kangouxu/two_bar_resume_base-on-RL/README.md

# two_bar_resume_base-on-RL
a easy and cheap device trained by rl and deployed on esp32
