kangouxu/two_bar_resume_base-on-RL/第2站_行为克隆实战.md

# 第 2 站：从零敲出行为克隆

> 第 1 站结尾你看到：随机策略 reward 为负，机器人起不来。
> 这一站我们**一行一行敲出 `my_pretrain.py`**：用一条"手写的示范轨迹"当教师，监督学习出一个"能大致起身"的初始策略。
>
> 对照实现：`RL/pretrain_robo1_from_scripted.py`、`RL/getup_reference.py`。

---

## 先说一件事：这一站改用完整版环境

第 1 站你敲的 `my_env.py` 是**理解版**（核心观测/动作/奖励）。从这一站开始要真正训练，需要环境的**完整版功能**：

- `reset` 能**指定初始姿态**（`options={"pose": ...}`），而不是只能随机；
- `info` 里能输出 `servo_angles`、`target`、`goal_pose` 等调试信息。

这些仓库的 `robo1_env.py` 都已经有了。**这一站我们直接 `import robo1_env`**（它就是你 `my_env.py` 的完整版，建议打开对比一下多了什么）。

`getup_reference.py`（示范轨迹）也是仓库现成的，不用敲。

---

## Step 0：确认依赖文件都在

在 `RL/` 目录下：

```powershell
python -c "from robo1_env import Robo1GetupEnv; from getup_reference import getup_sequence_for_pose; print('ok')"
```

预期输出：`ok`

再验证一下 `getup_reference.py` 里有多少条示范轨迹：

```powershell
python -c "from getup_reference import getup_sequence_for_pose; print(len(getup_sequence_for_pose('pitch_pos')))"
```

预期输出：`5`（`pitch_pos` 的示范是 5 个 waypoint）。

---

## Step 1：建文件，敲导入

新建 `my_pretrain.py`，敲：

```python
import numpy as np
import torch
import mujoco
from stable_baselines3 import PPO

from getup_reference import getup_sequence_for_pose
from robo1_env import FALLEN_POSES, Robo1GetupEnv, roll_pitch_to_quat
```

逐行说：

- `torch`：做梯度下降（行为克隆的监督学习）。
- `PPO`：我们**只用它的 policy 网络**当"学生"，PPO 训练到第 3 站才用。
- `getup_sequence_for_pose`：拿某姿态的示范 waypoint。
- `FALLEN_POSES`：四种倒地姿态的角度。
- `roll_pitch_to_quat`：摆扰动姿态时用到（和第 1 站你敲的一样）。

---

## Step 2：敲数据增强表

继续往下敲：

```python
POSE_VARIANTS_DEG = {
    "roll_pos": [(0.0, 0.0)],
    "roll_neg": [(0.0, 0.0)],
    "pitch_pos": [(0, 0), (-20, -20), (-20, 0), (-20, 20), (-10, -10), (-10, 10),
                  (0, -20), (0, 20), (10, -10), (10, 10), (20, -20), (20, 0), (20, 20)],
    "pitch_neg": [(0.0, 0.0)],
}
```

说明：

- 每个元素是 `(roll偏移°, pitch偏移°)`，表示"把机器人摆到倒地姿态后，再额外偏一点角度"。
- **只对 `pitch_pos` 做了 13 个变体**，其他只有 1 个——因为作者发现**前后倒（pitch）方向更难、对初始角度更敏感**。
- 作用：让策略别只记住"某一个精确角度"，而是学会"这个姿态附近都能起"。这是数据增强/泛化技巧。

---

## Step 3：敲 waypoint → 连续目标角

继续往下敲：

```python
def expert_target_schedule(env, sequence):
    targets = []
    prev = np.zeros(2, dtype=np.float64)
    for waypoint in sequence:
        for i in range(350):
            t = (i + 1) / 350
            ctrl = (1.0 - t) * prev + t * waypoint
            if i % env.frame_skip == env.frame_skip - 1:
                targets.append(ctrl.copy())
        prev = waypoint
    for _ in range(150):
        targets.append(np.zeros(2, dtype=np.float64))
    return targets
```

说明（逐块）：

- waypoint 只是几个"关键帧"，机器人不能瞬间跳过去，所以**线性插值**成平滑轨迹。
- 每个 waypoint 用 350 步插值；`i % frame_skip == frame_skip - 1` 是**每 20 步采样一次**——保证这条轨迹和 env 的动作频率一致。
- 末尾 150 步回零：起完身让舵机回正。

---

## Step 4：敲"误差 → 动作"的翻译

继续往下敲：

```python
def scripted_action(env, waypoint):
    error = waypoint - env.target
    return np.clip(error / env.target_delta, -1.0, 1.0).astype(np.float32)
```

**这是全文件最关键的一行。** 回忆第 1 站 env 的动作规则：`target += action * target_delta`。反推：要走到 `waypoint`，动作应该是 `(waypoint - target) / target_delta`。

这一行把示范的"**要去哪**"翻译成策略该输出的"**这一步动多少**"——示范轨迹和 RL 动作之间，就靠它搭桥。

---

## Step 5：敲 reset_variant（摆扰动初始姿态）

继续往下敲：

```python
def reset_variant(env, pose, roll_offset_deg, pitch_offset_deg):
    base_roll, base_pitch = FALLEN_POSES[pose]
    roll = base_roll + np.deg2rad(roll_offset_deg)
    pitch = base_pitch + np.deg2rad(pitch_offset_deg)

    env.data.qpos[:] = 0.0
    env.data.qvel[:] = 0.0
    env.data.qpos[0:3] = [0.0, 0.0, 0.08]
    env.data.qpos[3:7] = roll_pitch_to_quat(roll, pitch)
    env.target[:] = 0.0
    env.data.ctrl[:] = 0.0
    mujoco.mj_forward(env.model, env.data)

    for _ in range(env.settle_steps):
        env.data.ctrl[:] = 0.0
        mujoco.mj_step(env.model, env.data)

    env.target[:] = 0.0
    env.data.ctrl[:] = 0.0
    env.step_count = 0
    env.success_count = 0
    env.prev_upright = env._upright()
    env.current_pose_name = pose
    return env._get_obs(), {"pose": pose}
```

说明：

- 前几行：把倒地姿态的 `(roll, pitch)` 加上扰动偏移，转成四元数摆上去——和第 1 站 `_set_pose` 几乎一样，只是多了扰动。
- `settle_steps` 循环：让身体落地稳定再开始。
- 末尾重置 `target / step_count / prev_upright`，返回初始观测。

---

## Step 6：敲 collect_expert_data（滚数据）

继续往下敲：

```python
def collect_expert_data():
    observations = []
    actions = []
    for pose in ("roll_pos", "roll_neg", "pitch_pos", "pitch_neg"):
        for roll_off, pitch_off in POSE_VARIANTS_DEG[pose]:
            env = Robo1GetupEnv("robo1.xml", fallen_poses=(pose,))
            obs, _ = reset_variant(env, pose, roll_off, pitch_off)
            for waypoint in expert_target_schedule(env, getup_sequence_for_pose(pose)):
                action = scripted_action(env, waypoint)
                observations.append(obs.copy())
                actions.append(action.copy())
                obs, _, terminated, truncated, _ = env.step(action)
                if terminated or truncated:
                    break
    return (np.asarray(observations, dtype=np.float32),
            np.asarray(actions, dtype=np.float32))
```

说明：

- 双重循环：遍历 4 种姿态 × 各自的变体。
- 内层：把示范轨迹在 env 里**真实 roll-out**，每走一步记一对 `(观测, 动作)`——这就是监督学习的 `(输入, 标签)`。
- 注意记的是**这一步之前的 `obs`** 和**这一步要做的 `action`**，配对要正确。

**运行验证**（确认数据收集正常）：

```powershell
python -c "import my_pretrain; o, a = my_pretrain.collect_expert_data(); print(o.shape, a.shape)"
```

预期输出：`(N, 4) (N, 2)`，N 约 3600（具体略少，因为有些变体会提前 break）。

---

## Step 7：敲 main（行为克隆训练）

继续往下敲：

```python
def main():
    observations, actions = collect_expert_data()
    env = Robo1GetupEnv("robo1.xml")
    model = PPO("MlpPolicy", env, n_steps=512, batch_size=256,
                learning_rate=3e-4, gamma=0.99, verbose=0, device="cpu")

    obs_tensor = torch.as_tensor(observations, dtype=torch.float32, device=model.device)
    act_tensor = torch.as_tensor(actions, dtype=torch.float32, device=model.device)
    optimizer = torch.optim.Adam(model.policy.parameters(), lr=1e-3)

    for epoch in range(5000):
        dist = model.policy.get_distribution(obs_tensor)
        loss = torch.mean((dist.distribution.mean - act_tensor) ** 2)
        optimizer.zero_grad()
        loss.backward()
        optimizer.step()
        if epoch % 500 == 0:
            print(f"epoch {epoch}, loss {float(loss):.6f}")

    print("expert_samples:", len(observations))
    model.save("robo1_getup_ppo")

if __name__ == "__main__":
    main()
```

说明（关键几行）：

- `model = PPO(...)`：先建一个 PPO 对象，但**只用它的 `policy`（actor）网络**当学生。
- `dist.distribution.mean`：policy 网络输出的**预测动作**。
- `loss = mean((pred - act)^2)`：**MSE 监督损失**——让预测动作逼近示范动作。这就是行为克隆。
- 不调 `model.learn()`，而是手写 `optimizer` 循环——因为这是监督学习，不是强化学习。
- 训练完 `model.save` 存成 `robo1_getup_ppo`（这是第 3 站 PPO 精调的起点）。

**运行验证**：

```powershell
python my_pretrain.py
```

预期：`loss` 从某个值一路下降到很小（如从 0.1 降到 0.001 以下）；最后打印 `expert_samples: ~3600`。训练很快（数据量小）。

> 注意：`model.save` 会**覆盖**同名文件。如果目录里已有 `robo1_getup_ppo.zip`（仓库自带的训练好模型），建议先备份，或把这一站的输出改个名（如 `my_ppo`），免得覆盖掉现成模型。

---

## Step 8：验证——克隆出来的策略能起身吗

新建 `my_eval.py`，敲：

```python
from stable_baselines3 import PPO
from robo1_env import Robo1GetupEnv

model = PPO.load("robo1_getup_ppo")
for pose in ("roll_pos", "roll_neg", "pitch_pos", "pitch_neg"):
    env = Robo1GetupEnv("robo1.xml", fallen_poses=(pose,))
    obs, _ = env.reset(options={"pose": pose})
    best = -1.0
    for _ in range(env.max_steps):
        action, _ = model.predict(obs, deterministic=True)
        obs, _, terminated, truncated, info = env.step(action)
        best = max(best, info["upright"])
        if terminated or truncated:
            break
    print(pose, "best_upright:", round(best, 4))
```

```powershell
python my_eval.py
```

预期：四种姿态的 `best_upright` 都能到 **0.9 以上**（`upright > 0.95` 才算严格 `goal_pose`）。

如果某个姿态起不来，通常是那条示范 waypoint 不够好。这时可以用仓库的 `search_all_getup.py` **自动搜索更好的轨迹**：

```powershell
python search_all_getup.py --pose pitch_pos
```

它会暴力枚举 + 随机采样一批候选 waypoint，逐个试、打分，把最好的打印出来，你再回填到 `getup_reference.py`。

---

## 下一步

现在你有了一个"能大致起身"的初始策略，但它只会死记硬背示范，不够鲁棒。

下一站（**第 3 站**）用 PPO 在仿真里继续精调，把它打磨成"真会应对各种情况"的策略。
