kangouxu/two_bar_resume_base-on-RL/第4站_导出与实机部署.md

# 第 4 站：从零敲出导出脚本 + 实机部署

> 第 3 站你在仿真里练出了鲁棒策略。这一站把它从 Python 搬到 **M5Atom（ESP32 单片机）**。
> 前半部分**逐行敲出 `my_export.py`**（把策略变 C 头），后半部分**逐段读懂**现成固件 `robo03.ino`，最后照着清单部署。
>
> 对照实现：`RL/export_policy_header.py`、`Arduino/robo03/robo03.ino`。

---

## 先明确：策略网络到底长什么样

SB3 的 `MlpPolicy` 就是一个 4 进 2 出的小 MLP：

```
4 → 64 (tanh) → 64 (tanh) → 2 (线性)
```

- 前两层是 `policy_net`（隐藏层，用 **tanh** 激活）。
- 最后一层是 `action_net`（输出层，**无激活**，直接线性）。

导出就是把这三层的**权重和偏置**写成 C 数组，再手写一个"矩阵乘法 + tanh"的前向函数。ESP32 没有 Python，只能这样把网络"搬过去"。

---

## Step 0：确认有训练好的模型

```powershell
python -c "from stable_baselines3 import PPO; PPO.load('robo1_getup_ppo'); print('ok')"
```

预期输出：`ok`（用第 3 站训练好的模型，或仓库自带的）。

---

## Step 1：敲 my_export.py —— 提取权重

新建 `my_export.py`，敲：

```python
import re
from stable_baselines3 import PPO

def extract_layers(model):
    sd = model.policy.state_dict()
    weights, biases = {}, {}

    def order(key):
        if "policy_net" in key:
            m = re.search(r"policy_net\.(\d+)", key)
            return int(m.group(1)) if m else 0
        return 10 ** 6      # action_net 排最后

    for key, val in sd.items():
        if not ("policy_net" in key or "action_net" in key):
            continue
        if key.endswith(".weight"):
            weights[order(key)] = val.detach().cpu().numpy()
        elif key.endswith(".bias"):
            biases[order(key)] = val.detach().cpu().numpy()

    return [{"W": weights[i], "b": biases[i]} for i in sorted(weights)]
```

说明：

- `model.policy.state_dict()`：一个字典，key 是层名，value 是 PyTorch 张量。
- `order`：SB3 的 `policy_net` 是 `Sequential`，层名是 `policy_net.0`、`policy_net.2`……（Linear 和 Tanh 交替，Linear 在偶数位），所以用正则抓数字排序；`action_net` 用一个很大的数排到最后。
- 只收 `.weight` 和 `.bias`（Linear 层），忽略 Tanh（激活没有参数）。
- `val.detach().cpu().numpy()`：从 GPU 图里摘出来，转成 NumPy 数组。

---

## Step 2：敲 my_export.py —— 写 C 数组

继续往下敲：

```python
def write_c_array(name, arr):
    if arr.ndim == 2:
        rows, cols = arr.shape
        lines = [f"static const float {name}[{rows}][{cols}] = {{"]
        for row in arr:
            lines.append("    {" + ", ".join(f"{x:.8f}" for x in row) + "},")
        lines.append("};\n")
        return "\n".join(lines)
    else:
        return (f"static const float {name}[{arr.shape[0]}] = {{\n"
                + ", ".join(f"{x:.8f}" for x in arr) + "\n};\n")
```

说明：二维数组输出成 `static const float 名字[行][列] = { {...}, {...} };`，一维同理。`.8f` 保留 8 位小数，精度足够推理用。

---

## Step 3：敲 my_export.py —— 生成前向函数

继续往下敲：

```python
def generate_forward(layers):
    code = ["#include <math.h>",
            "static inline void forward_policy(const float input[], float output[]) {",
            "    const float *curr = input;"]
    for i, layer in enumerate(layers):
        W, b = layer["W"], layer["b"]
        out_dim, in_dim = W.shape
        code.append(f"    static float layer{i}[{out_dim}];")
        code.append(f"    for (int i = 0; i < {out_dim}; i++) {{")
        code.append(f"        float s = w{i}_bias[i];")
        code.append(f"        for (int j = 0; j < {in_dim}; j++)")
        code.append(f"            s += w{i}_weight[i][j] * curr[j];")
        if i < len(layers) - 1:
            code.append(f"        layer{i}[i] = tanhf(s);")   # 隐藏层 tanh
        else:
            code.append(f"        layer{i}[i] = s;")          # 输出层线性
        code.append("    }")
        code.append(f"    curr = layer{i};")
    final = layers[-1]["W"].shape[0]
    code.append(f"    for (int i = 0; i < {final}; i++) output[i] = curr[i];")
    code.append("}")
    return "\n".join(code)
```

说明（这是**全文件最关键的一段**）：

- 逐层生成 C 代码：每层先 `s = bias + Σ(weight × 输入)`，再写回 `layer`。
- **隐藏层用 `tanhf(s)`，输出层直接 `s`（线性）**——这必须和 PyTorch 里 MlpPolicy 的定义**完全一致**，否则实机推理结果对不上。
- 每层输出 `curr = layer{i}`，喂给下一层。这就是"矩阵乘法 + tanh"的前向传播，没有框架。

---

## Step 4：敲 my_export.py —— main

继续往下敲：

```python
def main():
    model = PPO.load("robo1_getup_ppo")
    layers = extract_layers(model)

    with open("policy_network.h", "w") as f:
        f.write("// Auto-generated policy-only MLP\n\n#pragma once\n\n")
        f.write(f"#define OBS_DIM {layers[0]['W'].shape[1]}\n")
        f.write(f"#define ACTION_DIM {layers[-1]['W'].shape[0]}\n\n")
        for i, layer in enumerate(layers):
            f.write(write_c_array(f"w{i}_weight", layer["W"]))
            f.write(write_c_array(f"w{i}_bias", layer["b"]))
        f.write(generate_forward(layers))
    print("Generated policy_network.h")

if __name__ == "__main__":
    main()
```

说明：

- `OBS_DIM` = 第一层权重的列数（=4），`ACTION_DIM` = 最后一层的行数（=2）。
- 依次写出每层的权重、偏置，最后写前向函数。

**运行验证**：

```powershell
python my_export.py
```

预期输出：`Generated policy_network.h`。打开看，开头应该是 `#define OBS_DIM 4`、`#define ACTION_DIM 2`，以及一堆 `static const float` 数组。

> 把生成的 `policy_network.h` 放进 `Arduino/robo03/` 目录，`robo03.ino` 会 `#include "policy_network.h"` 引用它。

---

## Step 5：逐段读懂 `robo03.ino`（固件是现成的，读+改）

下面不是敲，是**读懂**现成固件怎么和仿真对齐。打开 `Arduino/robo03/robo03.ino`，分四块读。

### 5.1 姿态估计：IMU + 卡尔曼滤波（对应仿真的 roll/pitch）

```cpp
// robo03.ino:185-189  加速度计算粗略角度
theta_X = atan2(accY, sqrt(accX*accX + accZ*accZ)) * RAD_TO_DEG;

// robo03.ino:513-520  卡尔曼融合陀螺仪 + 加速度计
kalAngleX = kalmanX.getAngle(theta_X, gyroX, dt);
pitch = kalAngleX * DEG_TO_RAD;
roll  = -kalAngleY * DEG_TO_RAD;
```

为什么卡尔曼：加速度计噪声大但有绝对参考，陀螺仪短时准但会漂移，卡尔曼融合两者得稳定角度。**这正好对应仿真里从四元数算出的 roll/pitch**。

### 5.2 控制循环（对应 env 的 step）

```cpp
// robo03.ino:146-163
float obs[OBS_DIM] = {roll, pitch, servo1_target, servo2_target};  // 组观测
float action[ACTION_DIM];
forward_policy(obs, action);                                        // 前向推理

servo1_target += action[0] * TARGET_DELTA_RAD;                      // 增量，和仿真一样
servo1_target = clampf(servo1_target, -TARGET_LIMIT_RAD, TARGET_LIMIT_RAD);
```

对照第 1 站 env 的 `step`：观测、动作增量、限幅，**逐行对应**。控制周期是 20ms（`GETUP_PERIOD_US=20000`，`robo03.ino:51`），正好 = 仿真 `frame_skip=20 × 0.001s`。

### 5.3 状态机 + 自动起身

`robo03.ino:39-44` 定义了几种模式：`MANUAL`（手动）/ `GETUP`（起身中）/ `GETUP_DONE`（成功）/ `GETUP_ABORT`（超时）。

两个实用机制：

- **成功判定**：roll、pitch 都小于阈值并保持 700ms → 判"站直"，停止策略（`robo03.ino:166-174`）。
- **自动起身**：检测倒地（倾角 > 0.75rad 持续 300ms）→ 自动触发起身（`robo03.ino:112-137`）。所以机器人倒了能自己爬起来。

### 5.4 舵机 PWM 映射

```cpp
// robo03.ino:71-79
int deg1 = (int)roundf(target1 * RAD_TO_DEG);
deg1 = (int)clampf(deg1, -90, 90);
servo1.write(-deg1 + 90);     // -90°..90° 映射到 0°..180°
```

策略输出弧度，舵机要 PWM 角度，这里做转换。换舵机时，`offset`/`pulse` 在 Web 界面调（`robo03.ino:294-396`），存 Preferences 持久化。

---

## Step 6：部署步骤清单

1. **装依赖**：Arduino IDE 装 `M5Atom`、`Kalman`、`ESP32Servo` 库，选 ESP32 板卡。
2. **导出策略**：`python my_export.py`，把 `policy_network.h` 放进 `Arduino/robo03/`。
3. **接线**：servo1 → GPIO 26，servo2 → GPIO 32。
4. **烧录**：Arduino IDE 打开 `robo03.ino`，编译上传到 M5Atom。
5. **上电**：M5Atom 建热点 `robo1`（密码 `password`），连上后浏览器访问 `http://192.168.42.1`。
6. **校准**：网页上把两个舵机的 `offset`（中心）和 `pulse`（行程）调到 ±90° 对应实际关节行程。
7. **起身**：网页点 `GETUP`，或按 M5Atom 本体按钮。

---

## sim-to-real gap 从哪来

代码全对，实机也不一定第一次就起。差距通常来自：

- **舵机扭矩不够**：MuJoCo 里执行器是理想化的（`kp=0.5`，没建模扭矩上限），换更弱的舵机可能甩不动。
- **装配/重心偏差**：3D 打印件重心和仿真 STL 不完全一致。
- **IMU 噪声**：卡尔曼参数没调好，姿态抖动。

这些不是 bug，是物理现实——所以这个项目把舵机偏移做成网页可调：**每个实机都不同，必须现场调**。

---

## 全流程回顾

四站走完，你走通了完整链路：

```
第1站 env ──► 第2站 行为克隆 ──► 第3站 PPO ──► 第4站 导出+实机
(观测/动作/奖励)  (示范轨迹)      (精调)        (C头 + M5Atom)
```

贯穿始终的那根线，就是**观测、动作、频率三条对齐**——它让仿真里每个设计决策，最终都在实体机器人的 20ms 循环里一一兑现。
