kangouxu/two_bar_resume_base-on-RL/armhornP.stl

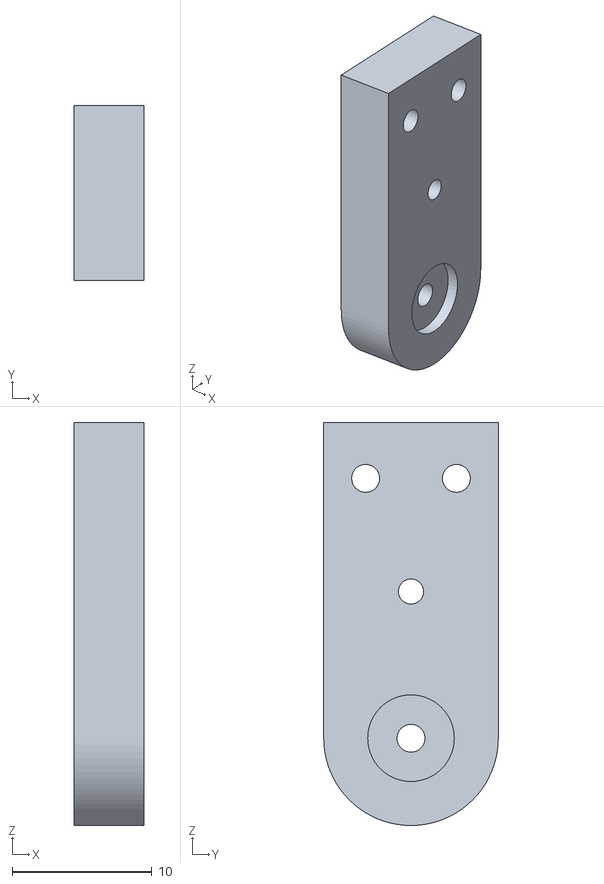
[picture p1: CAD file, 2026-10-21]
armhornP.stl
5.00 x 12.5 x 28.9
