kangouxu/two_bar_resume_base-on-RL/assets/servo1.stl

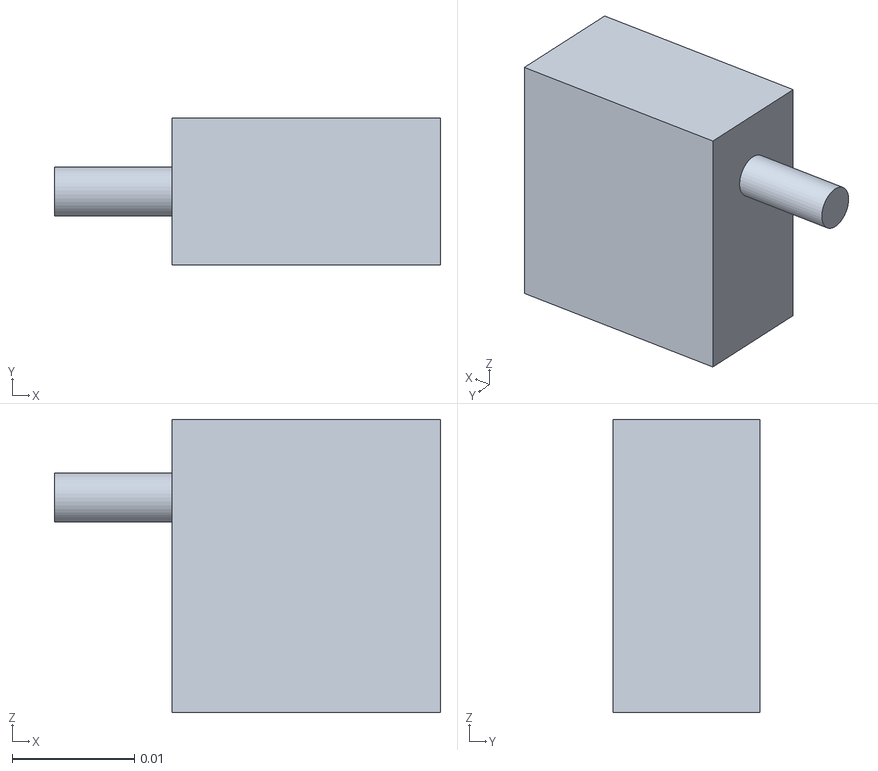
[picture p2: CAD file, 2026-10-16]
assets/servo1.stl
0.0316 x 0.012 x 0.024
