kangouxu/two_bar_resume_base-on-RL/arm2P.stl

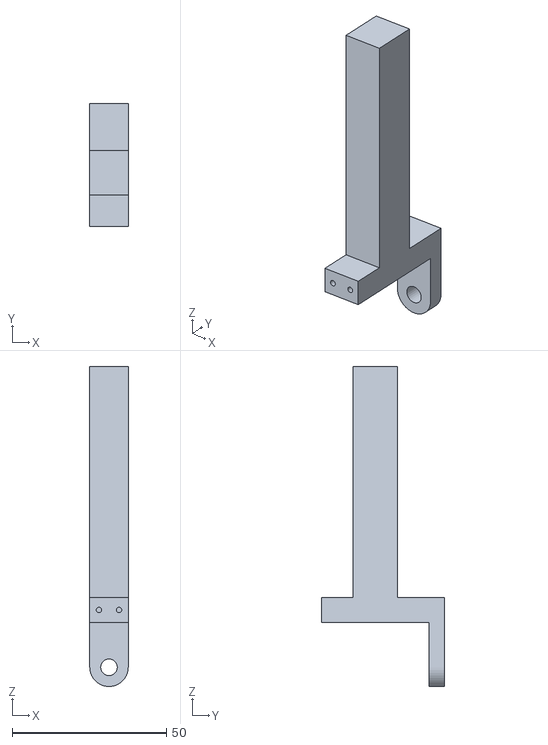
[picture p3: CAD file, 2026-10-21]
arm2P.stl
12.5 x 39.8 x 103.8
