kangouxu/two_bar_resume_base-on-RL/assets/arm2.stl

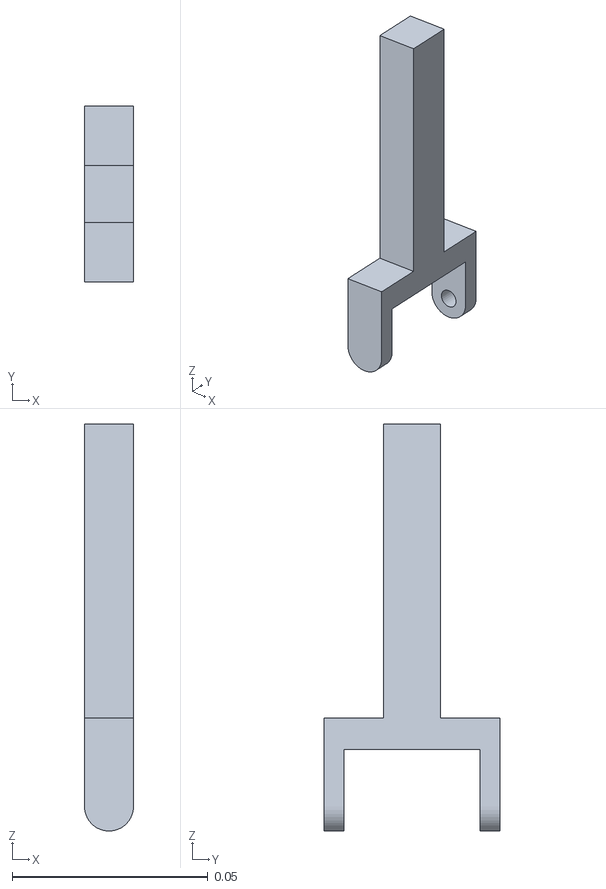
[picture p4: CAD file, 2026-10-16]
assets/arm2.stl
0.0125 x 0.0448 x 0.104
