kangouxu/two_bar_resume_base-on-RL/arm1P.3mf

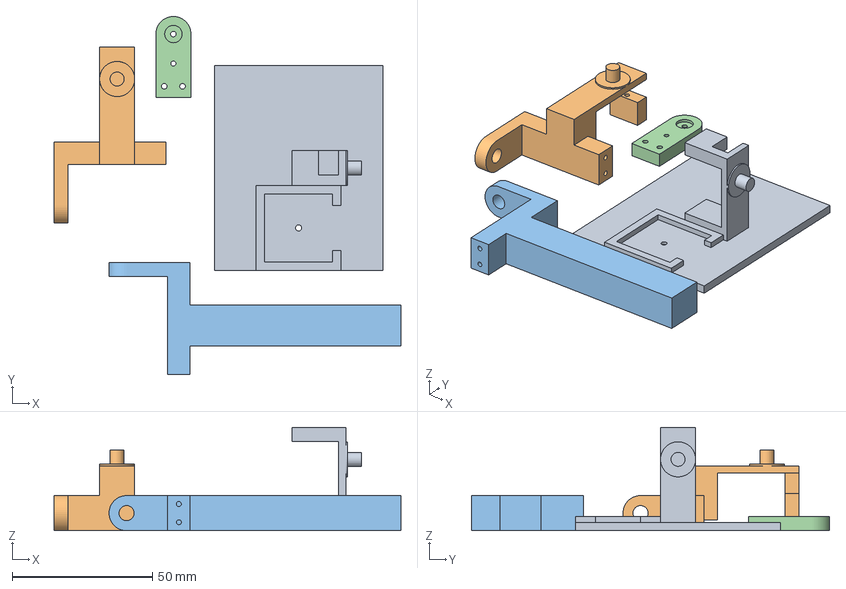
[picture p5: CAD file, 2026-10-21]
arm1P.3mf
123.4 x 127.4 x 36.8 mm
footP.stl
arm1P.stl
arm2P.stl
armhornP.stl
