kangouxu/two_bar_resume_base-on-RL/assets/arm1.stl

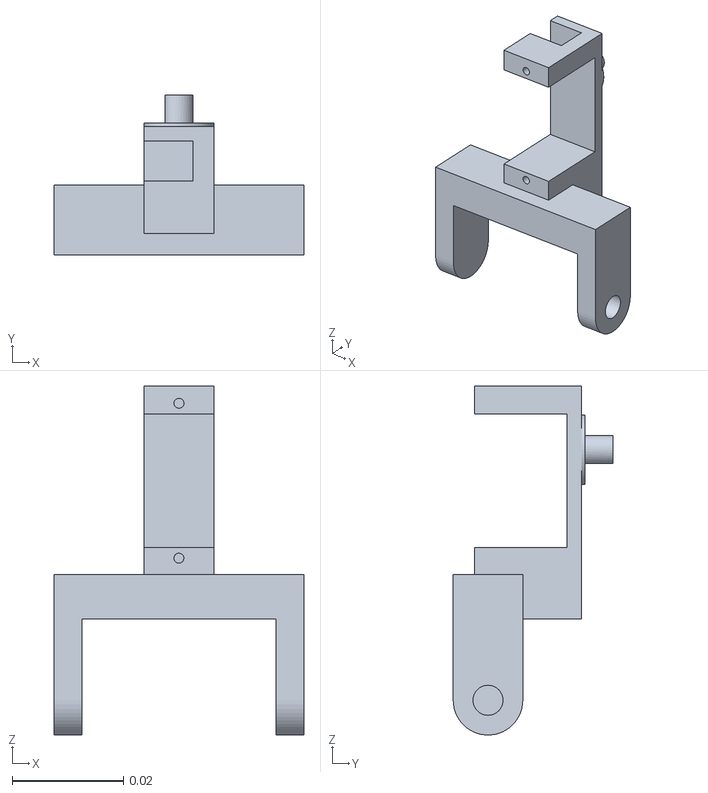
[picture p6: CAD file, 2026-10-16]
assets/arm1.stl
0.0448 x 0.0287 x 0.0626
