kangouxu/two_bar_resume_base-on-RL/footP.stl

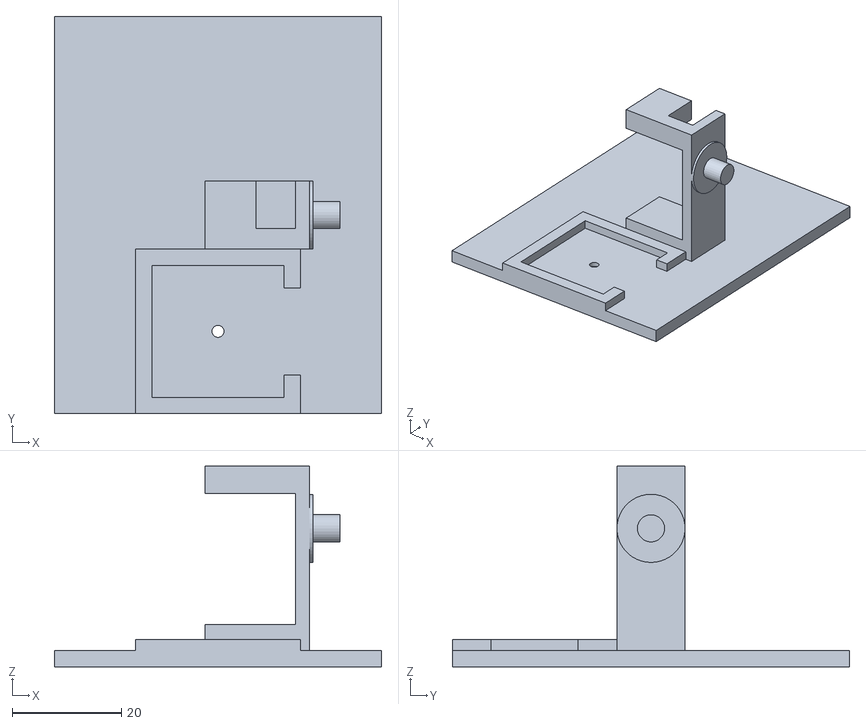
[picture p7: CAD file, 2026-10-21]
footP.stl
60.0 x 72.9 x 36.8
