kangouxu/two_bar_resume_base-on-RL/assets/ATOM.stl

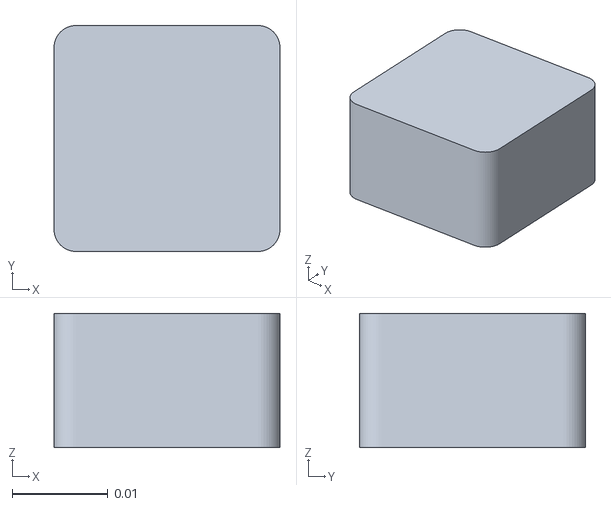
[picture p8: CAD file, 2026-10-16]
assets/ATOM.stl
0.0236 x 0.0236 x 0.014
