kangouxu/two_bar_resume_base-on-RL/assets/foot.stl

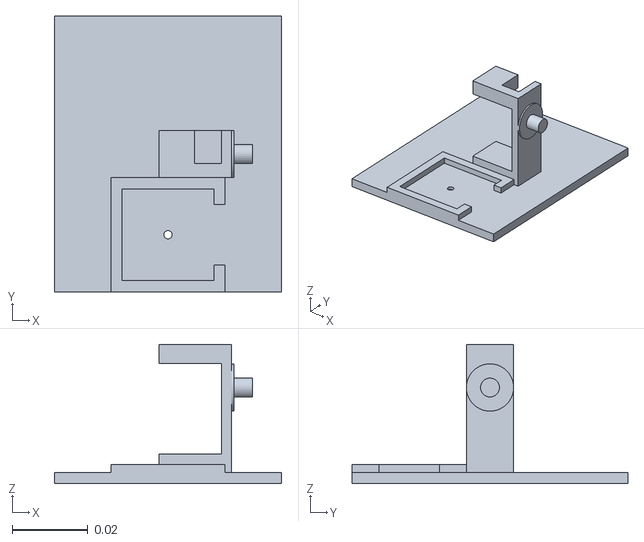
[picture p9: CAD file, 2026-10-16]
assets/foot.stl
0.06 x 0.0729 x 0.0368
