kangouxu/two_bar_resume_base-on-RL/(list of files, cad)

Other CAD files:
assets/servo2.stl
arm1P.stl
